sgmiller/tj-cluster/pcb/parts/tinypico-kicad-footprint/5.PNG

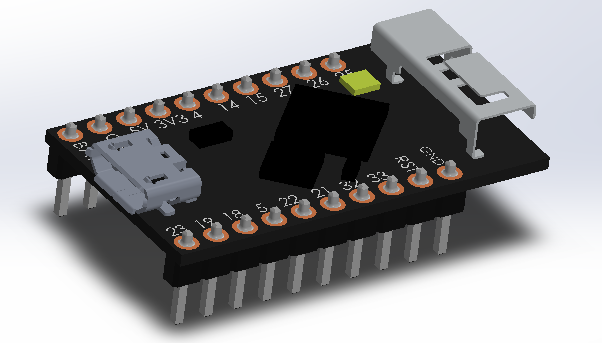
pcb/parts/tinypico-kicad-footprint/5.PNG
