sgmiller/tj-cluster/pcb/parts/tinypico-kicad-footprint/1.PNG

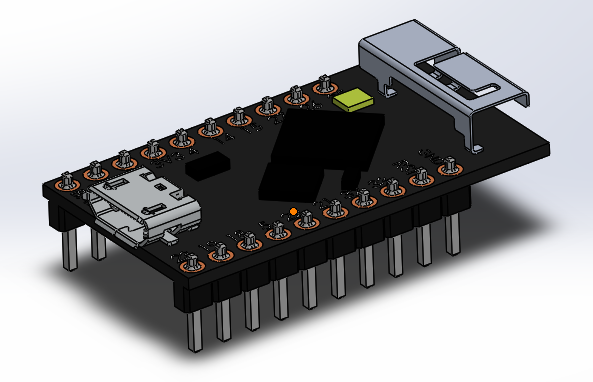
pcb/parts/tinypico-kicad-footprint/1.PNG
