sgmiller/tj-cluster/README.md

# tj-cluster
A custom PCB and software to drive Jeep TJ/XJ Dash clusters' CCD bus and receive CAN messages.
