sgmiller/tj-cluster/pcb/n9works.png

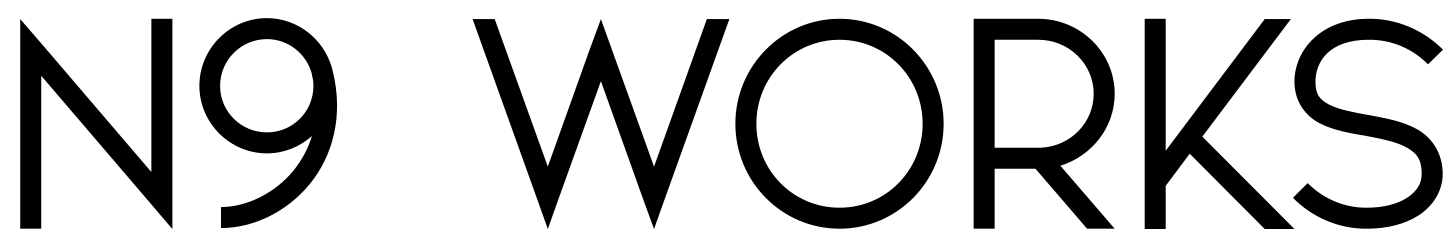
pcb/n9works.png
