sgmiller/tj-cluster/pcb/parts/tinypico-kicad-footprint/README.md

# TinyPICO KiCAD Symbol and Footprint

Based on design files published on 2019-05-21

[https://www.tinypico.com/](https://www.tinypico.com/)

[TinyPICO on crowdsupply](https://www.crowdsupply.com/unexpected-maker/tinypico)
