sgmiller/tj-cluster/pcb/XTJ-IC-Arbiter.ods

Source: | /home/scott/src/tj-cluster/pcb/XTJ-IC-Arbiter.kicad_sch
Date: | Mon 29 Aug 2022 05:52:24 PM CDT
Tool: | Eeschema 6.0.7-f9a2dced07~116~ubuntu20.04.1
Generator: | /usr/share/kicad/plugins/bom_csv_grouped_by_value_with_fp.py
Component Count: | 47
Ref | Qnty | PPU | Cost | Value | Cmp name | Footprint | Description | Vendor
C1, C4, | 2 | $0.28 | $0.56 | 3.3nF | C_Small | Capacitor_THT:C_Disc_D3.8mm_W2.6mm_P2.50mm | Unpolarized capacitor, small symbol
C2, C3, C5, | 3 | $0.24 | $0.73 | 25pF | C_Small | Capacitor_THT:C_Disc_D6.5mm_W4mm_P6.4mm | Unpolarized capacitor, small symbol
C6, C7, C8, C12, C13, C14, | 6 | $0.28 | $1.68 | 0.1uF | C | Capacitor_THT:C_Disc_D3.8mm_W2.6mm_P2.50mm
 | 0 | $0.28 | $0.00 | 0.1uf | C | Capacitor_THT:C_Disc_D3.8mm_W2.6mm_P2.50mm
C9, | 1 | $0.28 | $0.28 | 10nF | C_Small | Capacitor_THT:C_Axial_L3.8mm_D2.6mm_P7.50mm_Horizontal | Unpolarized capacitor, small symbol
C10, | 1 | $0.28 | $0.28 | 100uF | CP | Capacitor_THT:CP_Radial_D8.0mm_P3.50mm
C11, | 1 | $0.33 | $0.33 | 68uF | CP | Capacitor_THT:C_Radial_D6.3mm_H7.0mm_P2.50mm
D1, D2, | 2 | $0.25 | $0.50 | 1N4728 | D_Zener | Diode_THT:D_DO-41_SOD81_P7.62mm_Horizontal
D3, | 1 | $0.43 | $0.43 | P6KE39CA | P6KE39CA | Diode_THT:D_DO-15_P10.16mm_Horizontal | DO-15 Bidirectional TVS Diode, 39V, 600W, Alternate KiCAD Library
D4, D6, D7, D8, D10, | 5 | $0.14 | $0.70 | 3.3v | D_Zener | Diode_THT:D_DO-35_SOD27_P7.62mm_Horizontal | Zener diode
D5, D9, D12, D15, D16, | 5 | $0.32 | $1.60 | P6KE6.8CA | P6KE6.8CA | Diode_THT:D_DO-15_P10.16mm_Horizontal | DO-15 Bidirectional TVS Diode, 6.8V, 600W, Alternate KiCAD Library
D13, | 1 | $0.25 | $0.25 | 550mV | D_Zener | Diode_THT:D_DO-41_SOD81_P7.62mm_Horizontal
D14, | 1 | $0.39 | $0.39 | P6KE6.8A | P6KE6.8A | Diode_THT:D_DO-15_P10.16mm_Horizontal | DO-15 Unidirectional TVS diode, 6.8V, 600W, Alternate KiCAD Library
H1, H2, | 2 |  | $0.00 | MountingHole_Pad | MountingHole_Pad | MountingHole:MountingHole_3.2mm_M3 | Mounting Hole with connection
J3, | 1 | $25.13 | $25.13 | DTM13-12PA-R008 | DTM13-12PA-R008 | DTM13:TE_DTM13-12PA-R008
L1, | 1 | $0.50 | $0.50 | 47uH | L | Inductor_THT:L_Radial_D8.7mm_P5.00mm_Fastron_07HCP
OC1, | 1 | $1.79 | $1.79 | Optocoupler_Generic | Optocoupler_Generic | Package_DIP:DIP-4_W7.62mm | Optocoupler, Transistor output, Generic symbol, Alternate KiCAD Library
R1, R2, | 2 | $0.07 | $0.14 | 10ohm | R_Small | Resistor_THT:R_Axial_DIN0207_L6.3mm_D2.5mm_P7.62mm_Horizontal | Resistor, small symbol
R3, R11, | 2 | $0.10 | $0.20 | 120ohm | R_Small | Resistor_THT:R_Axial_DIN0207_L6.3mm_D2.5mm_P7.62mm_Horizontal | Resistor, small symbol
R7, | 1 | $0.08 | $0.08 | 2.2Kohm | R | Resistor_THT:R_Axial_DIN0207_L6.3mm_D2.5mm_P7.62mm_Horizontal | Resistor
R8, | 1 | $0.10 | $0.10 | 13Kohm | R | Resistor_THT:R_Axial_DIN0207_L6.3mm_D2.5mm_P7.62mm_Horizontal | Resistor
R9, | 1 | $0.63 | $0.63 | 20kOhm | R_Small | Resistor_THT:R_Axial_DIN0207_L6.3mm_D2.5mm_P7.62mm_Horizontal | Resistor, small symbol
R10, | 1 | $0.10 | $0.10 | 10kOhm | R_Small | Resistor_THT:R_Axial_DIN0207_L6.3mm_D2.5mm_P7.62mm_Horizontal | Resistor, small symbol
SW2, | 1 | $1.02 | $1.02 | SW_DIP_x02 | SW_DIP_x02 | Button_Switch_THT:SW_DIP_SPSTx02_Slide_9.78x7.26mm_W7.62mm_P2.54mm | 2x DIP Switch, Single Pole Single Throw (SPST) switch, small symbol
U1, | 1 | $5.60 | $5.60 | LM2672N-5.0 | LM2672N-5.0 | Package_DIP:DIP-8_W7.62mm | 5V, 1A Step-Down Voltage Regulator, DIP-8
U2, | 1 | $5.80 | $5.80 | CDP68HC68S1 | CDP68HC68S1 | Transceivers:CDP68HC68S1
U3, | 1 | $24.38 | $24.38 | Teensy4.0 | Teensy4.0 | MCUs:Teensy40_NoSMT
U4, | 1 | $1.51 | $1.51 | MCP2562-H-P | MCP2562-H-P | Package_DIP:DIP-8_W7.62mm | High-Speed CAN Transceiver, 1Mbps, 5V supply, Vio pin, -40C to +150C, DIP-8
N/A | 1 | $0.42 | $0.42 | Wedgelock
N/A | 1 | $17.67 | $17.67 | Automotive Enclosure
N/A | 1 | $3.80 | $3.80 | Deutch Plug
 |  | Total | $96.60
