sgmiller/tj-cluster/pcb/parts/tinypico-kicad-footprint/2.PNG

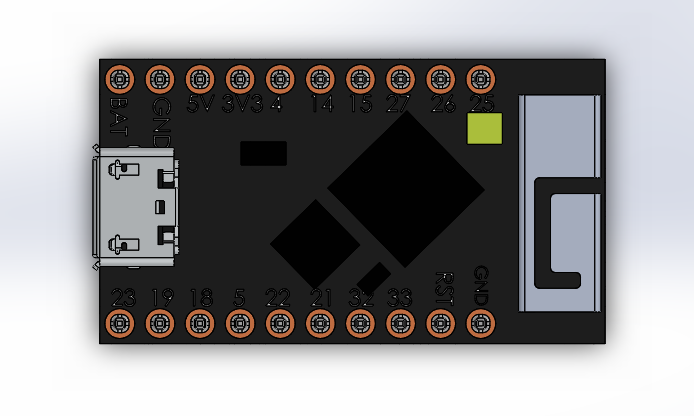
pcb/parts/tinypico-kicad-footprint/2.PNG
