sgmiller/tj-cluster/pcb/parts/tinypico-kicad-footprint/3.PNG

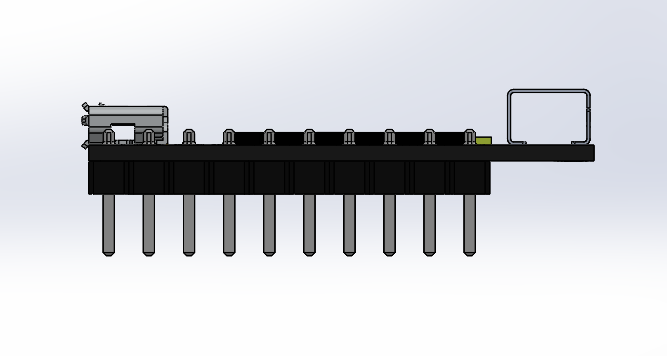
pcb/parts/tinypico-kicad-footprint/3.PNG
