sgmiller/tj-cluster/pcb/parts/tinypico-kicad-footprint/4.PNG

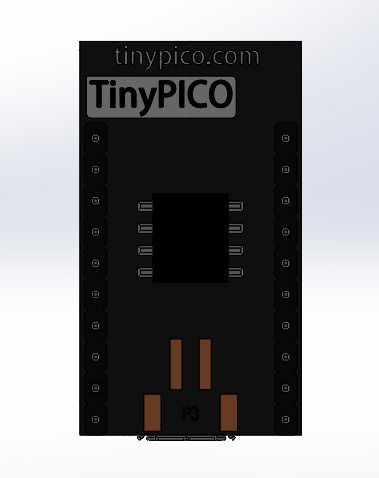
pcb/parts/tinypico-kicad-footprint/4.PNG
