sgmiller/tj-cluster/pcb/parts/DTM13/DTM13-12PA-R008.step

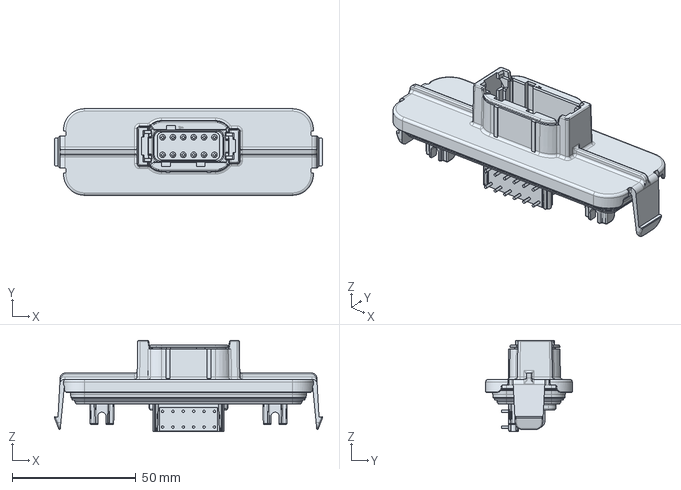
[picture p8: CAD file, 2022-06-14]
pcb/parts/DTM13/DTM13-12PA-R008.step
108.3 x 35.0 x 36.9 mm
