sgmiller/tj-cluster/pcb/parts/enclosure/EEC-325X4A.step

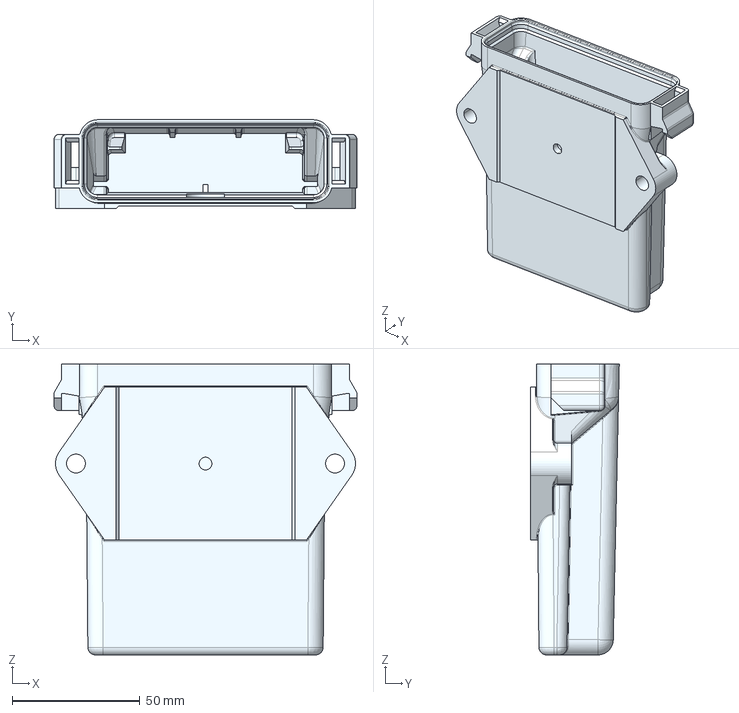
[picture p9: CAD file, 2025-09-23]
pcb/parts/enclosure/EEC-325X4A.step
118.8 x 34.7 x 114.0 mm
