sgmiller/tj-cluster/pcb/parts/FA18X7R1H472KNU00/3D/FA18X7R1H472KNU00.stp

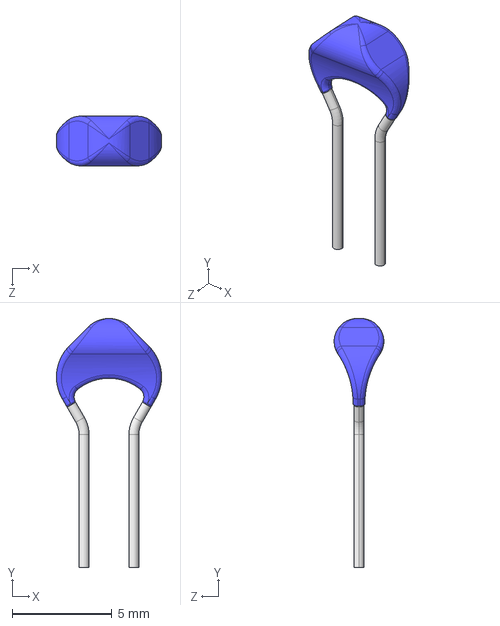
[picture p10: CAD file, 2025-09-12]
pcb/parts/FA18X7R1H472KNU00/3D/FA18X7R1H472KNU00.stp
5.28 x 12.5 x 2.50 mm
