sgmiller/tj-cluster/pcb/parts/FA24X7R1H105KRU06/3D/FA24X7R1H105KRU06.stp

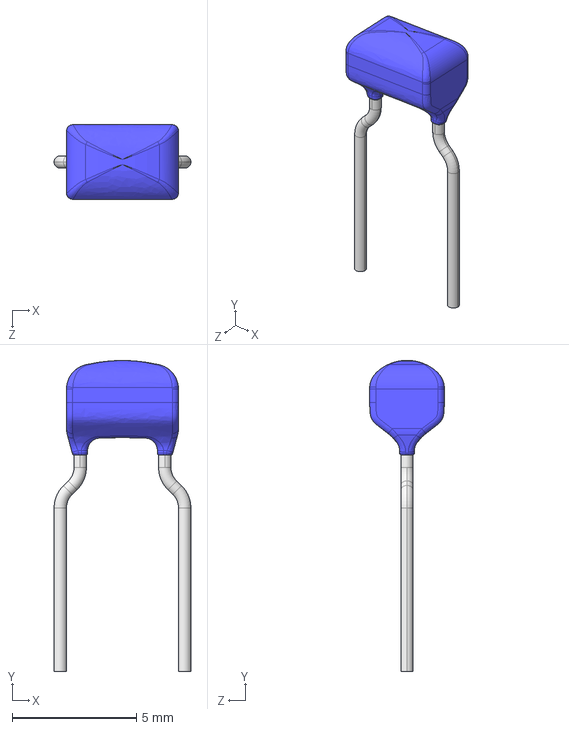
[picture p11: CAD file, 2025-09-07]
pcb/parts/FA24X7R1H105KRU06/3D/FA24X7R1H105KRU06.stp
5.50 x 12.5 x 3.00 mm
