sgmiller/tj-cluster/pcb/parts/fuse/MF-MSMF050.step

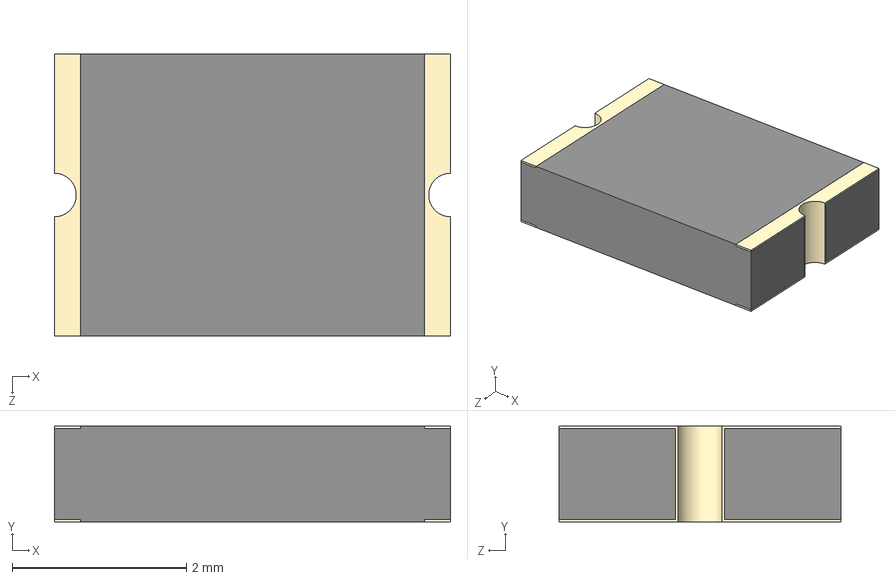
[picture p12: CAD file, 2025-11-19]
pcb/parts/fuse/MF-MSMF050.step
4.55 x 1.10 x 3.24 mm
