sgmiller/tj-cluster/pcb/parts/Jumpers/TSW-101-07-T-D.step

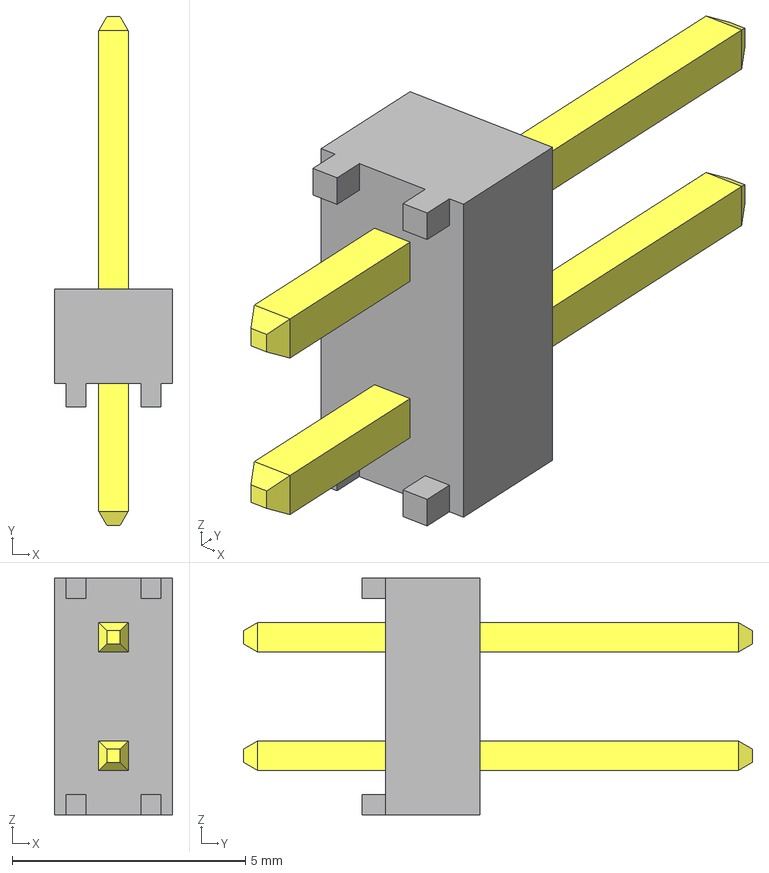
[picture p13: CAD file, 2022-06-14]
pcb/parts/Jumpers/TSW-101-07-T-D.step
2.54 x 10.9 x 5.08 mm
_TSW-101-07-T-D_body
_T-1S6-07-TSW-1-07-1-D
