sgmiller/tj-cluster/pcb/parts/MCUs/Teensy_4_Pins.FCStd

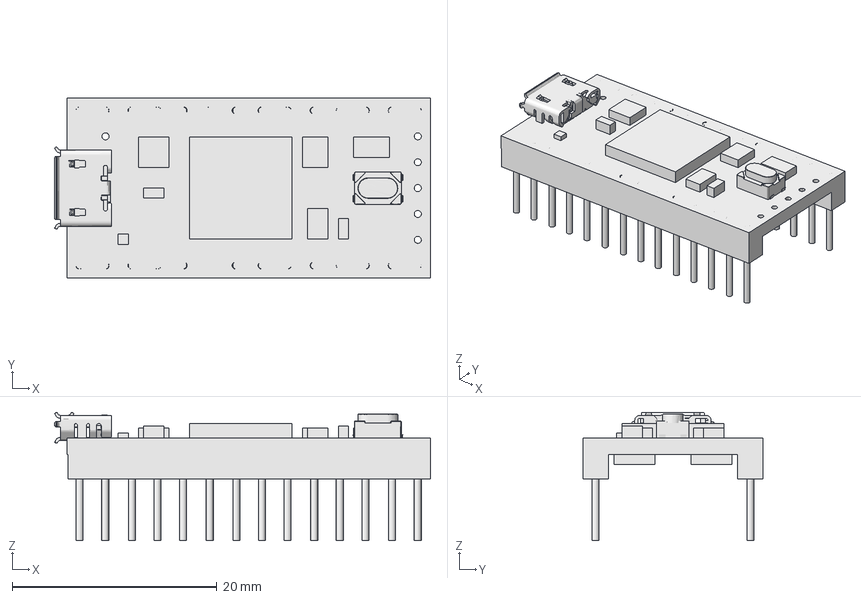
[picture p14: CAD file, 2022-07-18]
pcb/parts/MCUs/Teensy_4_Pins.FCStd
36.7 x 17.6 x 12.5 mm
