sgmiller/tj-cluster/pcb/parts/Power_Regulator/LM2591HVT-5.0.step

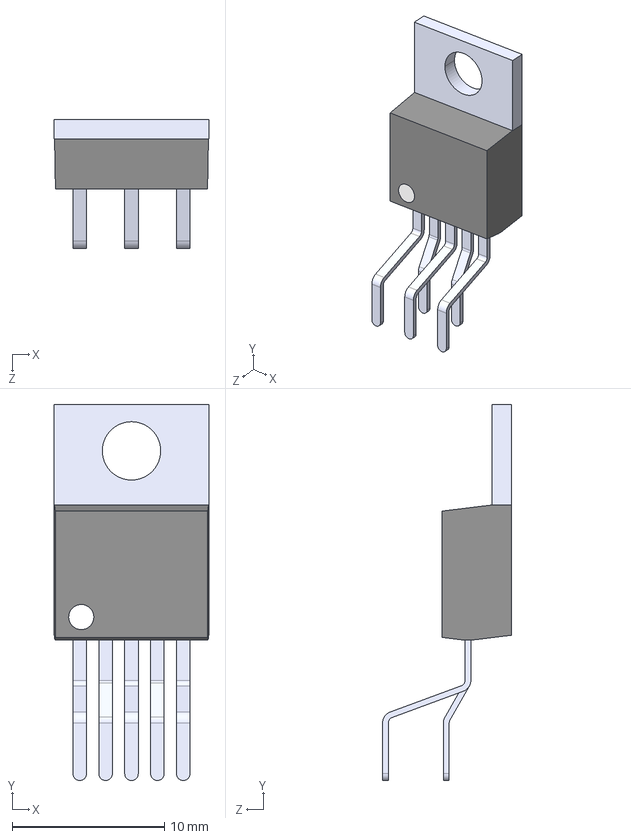
[picture p15: CAD file, 2022-07-01]
pcb/parts/Power_Regulator/LM2591HVT-5.0.step
10.2 x 24.7 x 8.47 mm
