sgmiller/tj-cluster/pcb/parts/RLB0914-470KL/3D/RLB0914-470KL.stp

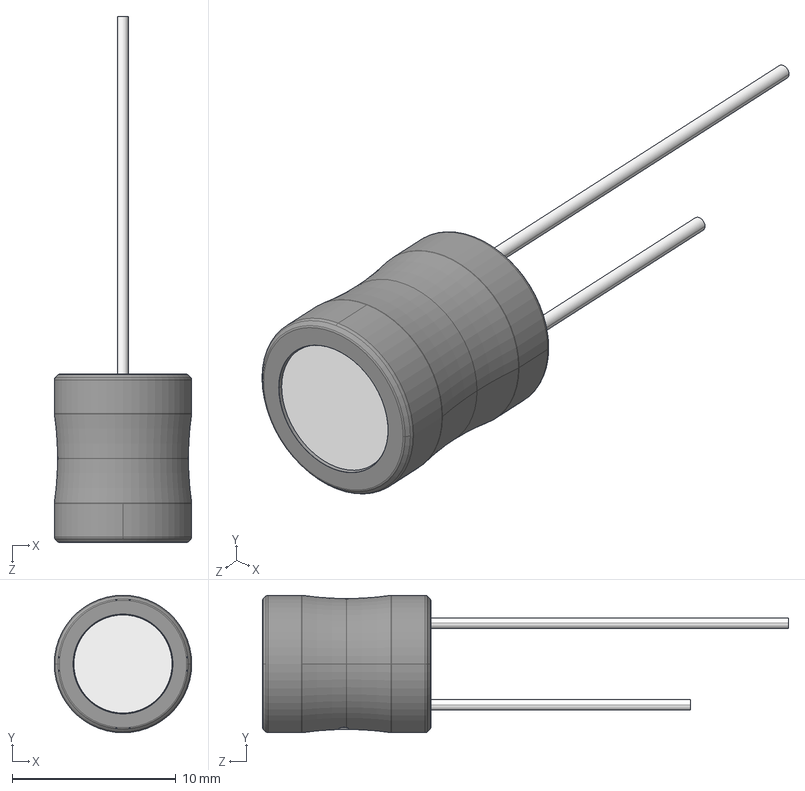
[picture p16: CAD file, 2025-09-07]
pcb/parts/RLB0914-470KL/3D/RLB0914-470KL.stp
8.40 x 8.40 x 32.1 mm
