sgmiller/tj-cluster/pcb/parts/RXEF050S/3D/RXEF050S.stp

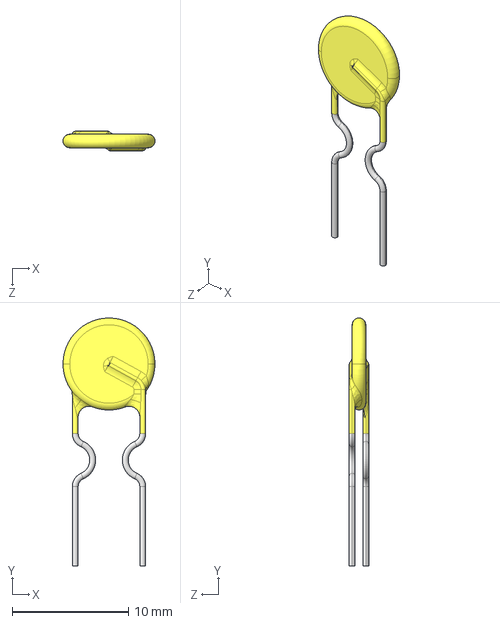
[picture p17: CAD file, 2025-11-18]
pcb/parts/RXEF050S/3D/RXEF050S.stp
7.90 x 21.3 x 1.68 mm
