sgmiller/tj-cluster/pcb/parts/SA26A/3D/SA26A.stp

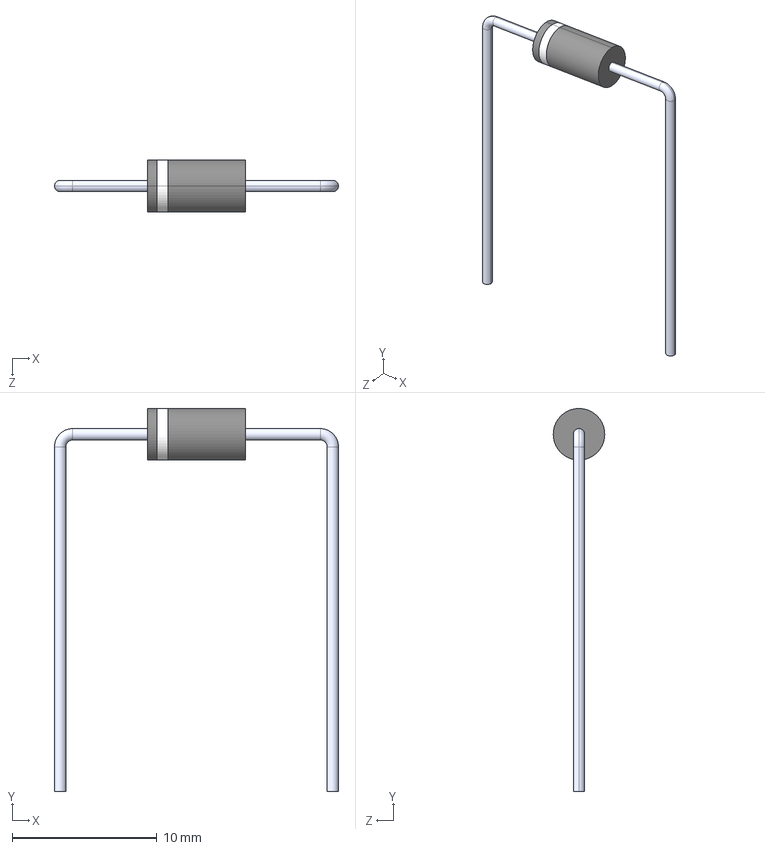
[picture p18: CAD file, 2025-10-22]
pcb/parts/SA26A/3D/SA26A.stp
19.6 x 26.4 x 3.56 mm
P6KE10_3_1
P6KE10_1_1
P6KE10_4 x 2
