sgmiller/tj-cluster/pcb/parts/TLV3704IN/3D/TLV3704IN.stp

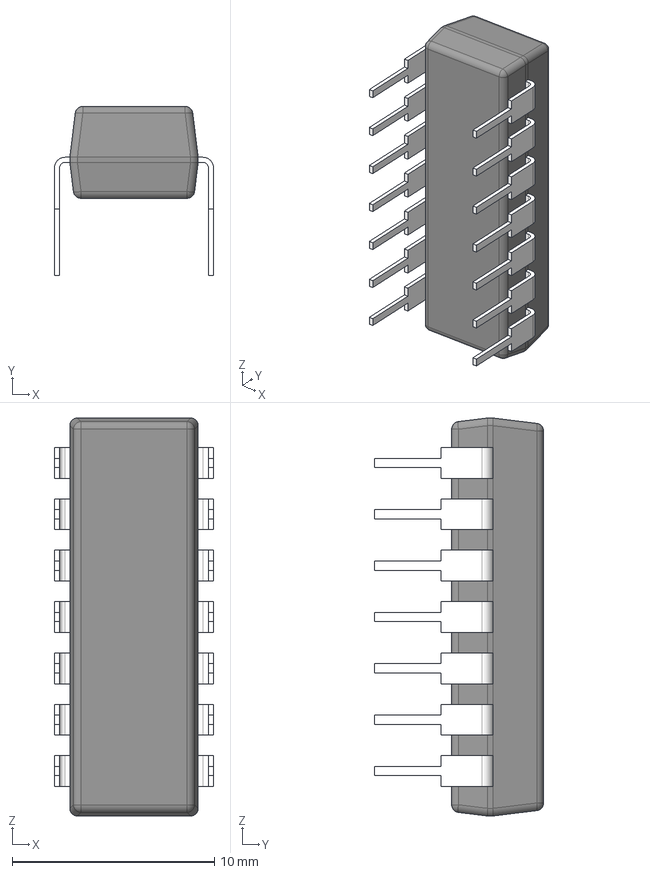
[picture p19: CAD file, 2025-09-07]
pcb/parts/TLV3704IN/3D/TLV3704IN.stp
7.87 x 8.37 x 19.7 mm
BODY_N0014A_AF0
LEAD_N0014A_AF1
LEAD_N0014A x 10
LEAD_N0014A_AF3
LEAD_N0014A_AF0
LEAD_N0014A_AF2
