sgmiller/tj-cluster/pcb/parts/G6L-1P_DC5.step

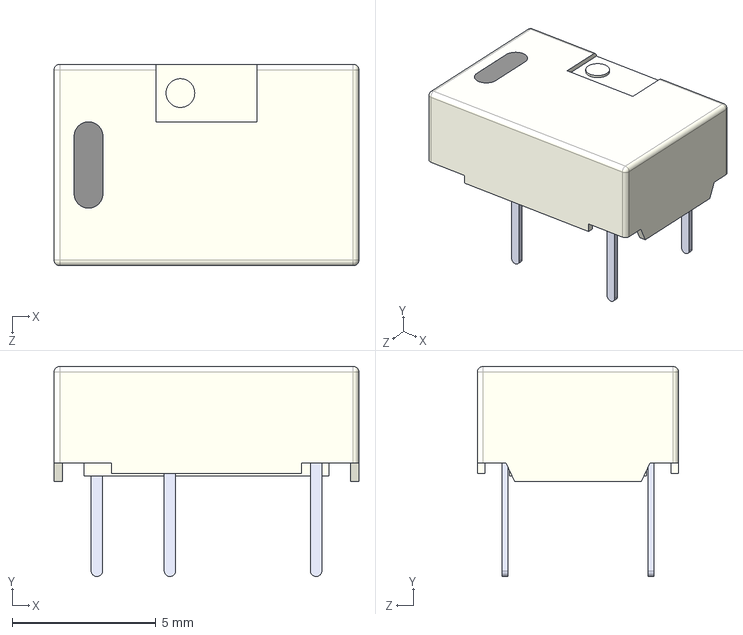
[picture p20: CAD file, 2025-08-30]
pcb/parts/G6L-1P_DC5.step
10.6 x 7.30 x 7.00 mm
