sgmiller/tj-cluster/pcb/parts/39811000000.step

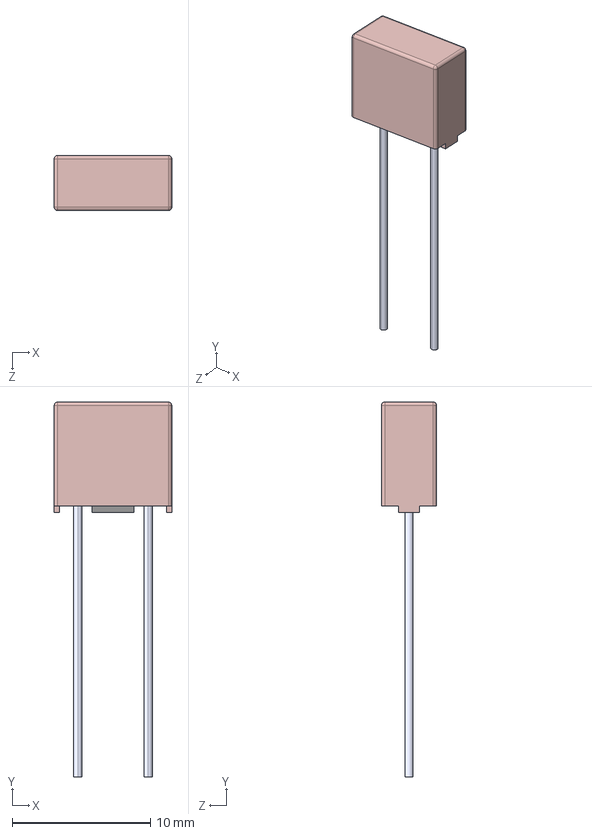
[picture p21: CAD file, 2025-10-07]
pcb/parts/39811000000.step
8.50 x 27.1 x 4.00 mm
