sgmiller/tj-cluster/(list of files, drawings)

Other design files:
pcb/XTJ-IC-Arbiter.dsn
