sgmiller/tj-cluster/pcb/XTJ-IC-Arbiter.kicad_pcb

## KiCad design pcb/XTJ-IC-Arbiter.kicad_pcb (2026-08-17)

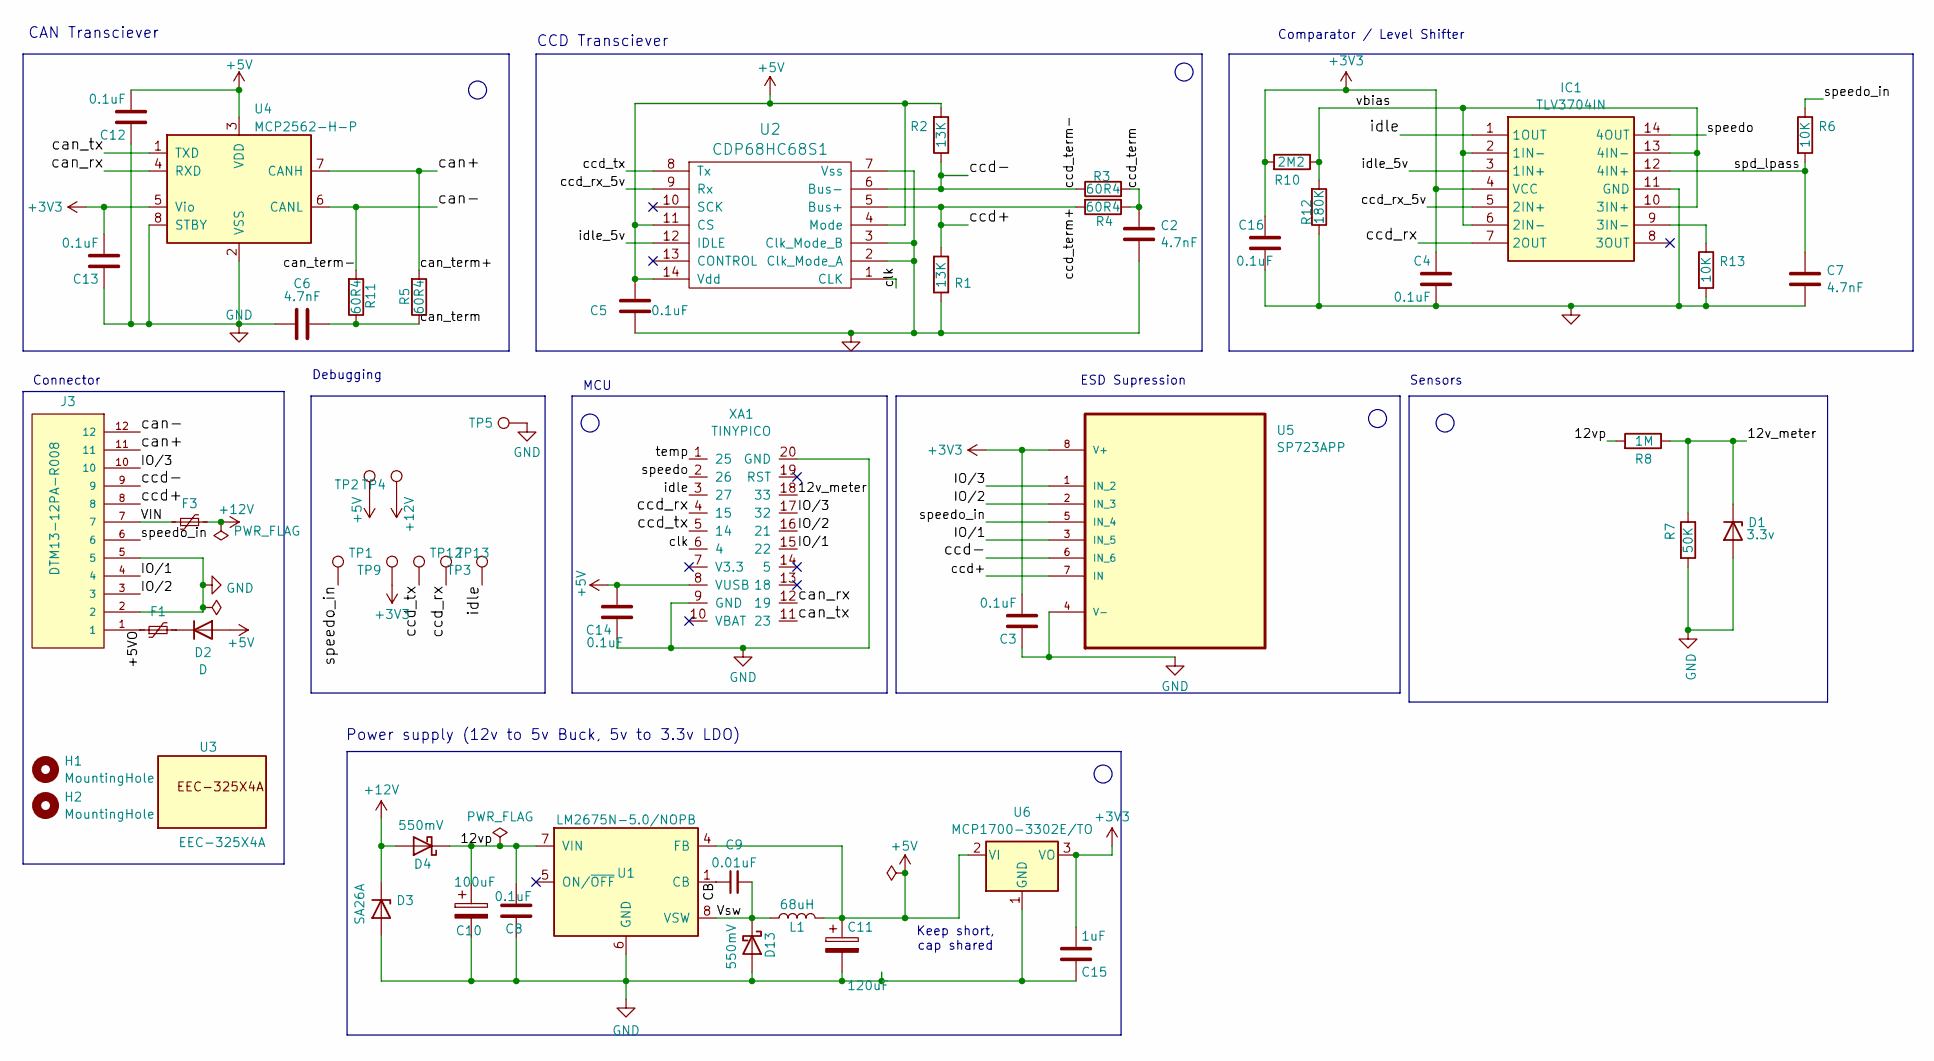
[picture p22: schematic XTJ-IC-Arbiter.kicad_sch, XJ/TJ CCD/CAN bus arbiter]

Parts:
C2, C6, C7: 4.7nF; C_Disc_D3.8mm_W2.6mm_P2.50mm; MPN AR151C472K4R
C3, C4, C5, C8, C12, C13, C14, C16: 0.1uF; C_Disc_D4.7mm_W2.5mm_P5.00mm; MPN K103K10X7RF53L2
C9: 0.01uF; C_Disc_D3.8mm_W2.6mm_P2.50mm; MPN K103K10X7RF53L2
C10: 100uF; C_Radial_D8.0mm_H11.5mm_P3.50mm; MPN EEU-FR1V101
C11: 120uF; CP_Radial_D8.0mm_P3.50mm; MPN EEU-FR1H121L
C15: 1uF; FA24; MPN FA24X7R1H105KRU06
D1: 3.3v; D_DO-35_SOD27_P7.62mm_Horizontal; MPN TZX3V3B-TR
D2: D; D_DO-41_SOD81_P7.62mm_Horizontal; MPN 1N40001GH
D3: SA26A; D_DO-15_P10.16mm_Horizontal; MPN SA26A; Mouser Part Number 576-SA26CA
D4, D13: 550mV; D_DO-41_SOD81_P7.62mm_Horizontal; MPN MBR160RLG
F1, F3: Polyfuse_Small; Fuse_1812_4532Metric_Pad1.30x3.40mm_HandSolder; MPN MF-MSMF050/30X-2
H1, H2: MountingHole; MountingHole_3mm
IC1: TLV3704IN; DIP794W53P254L1930H508Q14N; Mouser Part Number 595-TLV3704IN
J3: DTM13-12PA-R008; TE_DTM13-12PA-R008
L1: 68uH; L_Radial_D7.8mm_P5.00mm_Fastron_07HCP; MPN 744731680
R1, R2: 13K; R_Axial_DIN0207_L6.3mm_D2.5mm_P7.62mm_Horizontal; MPN MF1/4DC1302F
R3, R4, R5, R11: 60R4; R_Axial_DIN0207_L6.3mm_D2.5mm_P7.62mm_Horizontal; MPN CMF5560R400FHEK
R6, R13: 10K; R_Axial_DIN0207_L6.3mm_D2.5mm_P7.62mm_Horizontal; MPN MF1/4DC4701F
R7: 50K; R_Axial_DIN0207_L6.3mm_D2.5mm_P7.62mm_Horizontal; MPN MF1/4DC4701F
R8: 1M; R_Axial_DIN0207_L6.3mm_D2.5mm_P7.62mm_Horizontal; MPN MFR-25FBF52-100K
R10: 2M2; R_Axial_DIN0207_L6.3mm_D2.5mm_P7.62mm_Horizontal; MPN MF1/4LCT52R225J
R12: 180K; R_Axial_DIN0207_L6.3mm_D2.5mm_P7.62mm_Horizontal; MPN MF1/4DCT52R1803F
TP1, TP3, TP5, TP12, TP13: TestPoint; TestPoint_Loop_D2.50mm_Drill1.0mm; MPN 534-5267
TP2, TP4, TP9: TestPoint; TestPoint_Plated_Hole_D2.0mm; MPN 534-5267
U1: LM2675N-5.0/NOPB; DIP-8_W7.62mm; MPN LM2675N-5.0/NOPB
U2: CDP68HC68S1; DIP-14_W7.62mm; MPN CDP68HC68S1
U3: EEC-325X4A; TE_EEC-325X4A; PARTREV F
U4: MCP2562-H-P; DIP-8_W7.62mm; MPN MCP2562-H-P
U5: SP723APP; DIP-8_W7.62mm; MPN SP723APP
U6: MCP1700-3302E/TO; TO-92_Inline_Wide; MPN MCP1700-3302E/TO
XA1: TINYPICO

Connections:
+3V3: C3.2, C4.1, C13.2, C15.2, C16.2, IC1.4 (VCC), R10.2, TP9.1, U4.5 (Vio), U5.8 (V+), U6.3 (VO)
+5V: C5.2, C11.1, C12.2, C14.2, D2.2 (A), L1.2, R2.2, TP2.1, U1.4 (FB), U2.4 (Mode), U2.11 (CS), U2.14 (Vdd), U4.3 (VDD), U6.2 (VI), XA1.8 (VUSB)
+12V: D3.1 (K), D4.2 (A), F3.2, TP4.1
/12v_meter: D1.1 (K), R7.1, R8.1, XA1.18 (33)
/12vp: C8.2, C10.1, D4.1 (K), R8.2, U1.7 (VIN)
/+5VO: F1.1, J3.1
/CB: C9.1, U1.1 (CB)
/IO/1: J3.4, U5.3 (IN_5), XA1.15 (22)
/IO/2: J3.3, U5.2 (IN_3), XA1.16 (21)
/IO/3: J3.10, U5.1 (IN_2), XA1.17 (32)
/VIN: F3.1, J3.7
/Vsw: C9.2, D13.1 (K), L1.1, U1.8 (VSW)
/can+: J3.11, R5.2, U4.7 (CANH)
/can-: J3.12, R11.2, U4.6 (CANL)
/can_rx: U4.4 (RXD), XA1.12 (19)
/can_term: C6.2, R5.1, R11.1
/can_tx: U4.1 (TXD), XA1.11 (23)
/ccd+: J3.8, R1.2, R4.2, U2.5 (Bus+), U5.7 (IN)
/ccd-: J3.9, R2.1, R3.1, U2.6 (Bus-), U5.6 (IN_6)
/ccd_rx: IC1.7 (2OUT), TP13.1, XA1.4 (15)
/ccd_rx_5v: IC1.5 (2IN+), U2.9 (Rx)
/ccd_term: C2.2, R3.2, R4.1
/ccd_tx: TP12.1, U2.8 (Tx), XA1.5 (14)
/clk: U2.1 (CLK), XA1.6 (4)
/idle: IC1.1 (1OUT), TP3.1, XA1.3 (27)
/idle_5v: IC1.3 (1IN+), U2.12 (IDLE)
/spd_lpass: C7.2, IC1.12 (4IN+), R6.2
/speedo: IC1.14 (4OUT), XA1.2 (26)
/speedo_in: J3.6, R6.1, TP1.1, U5.5 (IN_4)
/temp: XA1.1 (25)
/vbias: IC1.2 (1IN-), IC1.6 (2IN-), IC1.10 (3IN+), IC1.13 (4IN-), R10.1, R12.2
GND: C2.1, C3.1, C4.2, C5.1, C6.1, C7.1, C8.1, C10.2, C11.2, C12.1, C13.1, C14.1, C15.1, C16.1, D1.2 (A), D3.2 (A), D13.2 (A), IC1.11 (GND), J3.2, J3.5, R1.1, R7.2, R12.1, R13.2, TP5.1, U1.6 (GND), U2.2 (Clk_Mode_A), U2.3 (Clk_Mode_B), U2.7 (Vss), U4.2 (VSS), U4.8 (STBY), U5.4 (V-), U6.1 (GND), XA1.9 (GND), XA1.20 (GND)
unnamed: D2.1 (K), F1.2
unnamed: IC1.9 (3IN-), R13.1

Notes on the sheet:
CAN Transciever
MCU
Debugging
Sensors
CCD Transciever
ESD Supression
Power supply (12v to 5v Buck, 5v to 3.3v LDO)
Keep short, cap shared
Comparator / Level Shifter
Connector

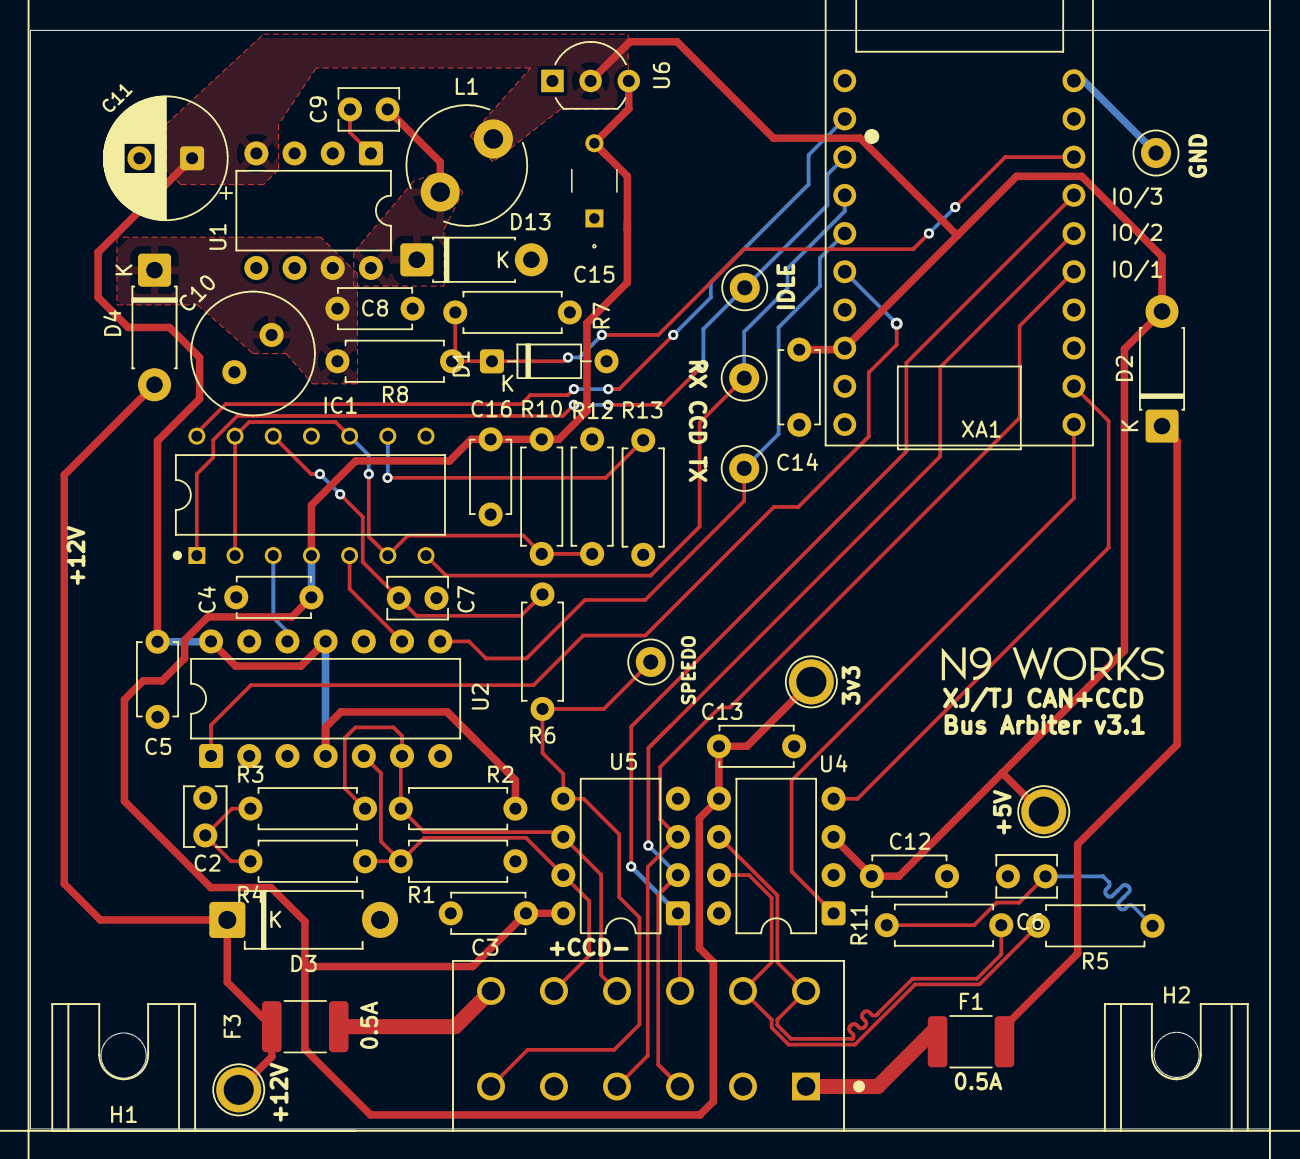
[picture p23: board XTJ-IC-Arbiter.kicad_pcb from above]

Board: 2 copper layers, 82.4 x 73.0 mm, 54 parts (0 on the bottom side), 33 nets.
