sgmiller/tj-cluster/include/main.h

#ifndef MAIN_H
#define MAIN_H

#include <Arduino.h>

const int ADC_LUT[4096] = { 0,
208,208,208,208,208,208,208,208,208,208,208,208,208,208,208,208,
208,208,208,208,208,208,208,208,208,208,208,208,208,208,208,208,
208,208,208,208,208,208,208,208,208,208,208,208,208,208,208,208,
208,208,208,208,208,208,208,208,208,208,208,208,208,208,208,208,
208,208,208,208,208,208,208,208,208,208,208,208,208,208,208,208,
208,208,208,208,208,208,208,208,208,208,208,208,208,208,208,208,
208,208,208,208,208,208,208,208,208,208,208,208,208,208,208,208,
208,208,208,208,208,208,208,208,208,208,208,208,208,208,208,208,
208,208,208,208,208,208,208,208,208,208,209,210,210,211,211,212,
207,213,214,214,215,215,216,217,217,218,218,219,220,220,221,221,
222,240,233,226,243,244,245,246,247,249,250,251,252,253,254,204,
256,257,204,258,259,259,260,261,261,262,263,203,203,265,203,266,
267,267,268,269,269,270,271,202,202,202,276,278,280,282,283,285,
287,289,290,291,293,294,296,297,298,300,301,303,304,306,307,309,
310,312,313,315,316,318,320,321,323,324,326,327,329,330,332,334,
335,198,198,339,340,341,342,343,344,345,346,347,348,197,197,351,
353,354,355,356,357,358,359,196,362,363,364,365,366,367,368,368,
369,369,370,370,195,371,371,372,372,372,373,373,194,374,194,375,
375,376,376,376,377,377,193,378,193,379,379,193,380,380,381,381,
382,382,192,401,383,406,408,411,413,415,416,417,418,419,419,420,
421,191,422,423,424,424,425,426,427,190,428,429,430,430,431,432,
432,433,433,434,434,435,189,436,189,437,438,438,439,439,440,440,
188,188,188,442,443,443,444,444,445,445,446,446,460,453,467,469,
470,472,473,474,476,477,479,480,186,186,482,483,484,485,485,486,
487,488,489,489,490,491,492,493,493,494,495,496,496,497,498,184,
184,500,501,501,502,503,504,504,505,4094,507,507,508,509,509,510,
511,512,513,514,515,182,182,519,520,521,523,524,525,527,528,529,
531,532,534,536,537,539,540,542,543,545,547,548,550,180,554,555,
557,559,560,561,562,562,563,564,565,565,566,567,568,568,569,570,
571,572,572,573,574,178,575,577,579,581,583,585,587,590,592,593,
593,594,177,595,596,597,4094,598,599,600,600,601,176,176,603,604,
605,605,606,607,607,608,609,175,175,611,612,612,613,614,615,615,
616,617,617,618,619,620,620,621,622,622,623,624,626,628,629,631,
633,635,637,173,640,641,641,642,643,643,644,644,645,646,646,647,
648,648,649,172,650,651,651,652,653,653,654,171,655,656,171,659,
660,661,662,664,665,666,668,669,670,671,170,673,674,675,170,677,
678,679,680,681,682,683,169,685,685,686,687,690,695,701,704,705,
705,706,706,707,707,168,708,709,709,168,710,711,711,712,712,713,
713,167,714,715,715,716,716,717,717,718,718,719,719,725,736,737,
738,739,740,741,166,743,744,745,746,747,748,749,165,752,753,754,
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
} ;

void clusterWrite();
void handleHeartbeat();
void handleSpeedSensor();
void watchdogFeed();
void setupSpeedo();

#endif
