sgmiller/tj-cluster/(commit log)

2022-06-05 Add PCB
    [Circuit-rewrite.kicad_pcb, Circuit.dsn, Circuit.kicad_pcb, Circuit.kicad_sch, canbus.kicad_sch, power.kicad_sch]
2022-06-08 Working oil and battery gauges
    [Circuit.csv, Circuit.kicad_pcb]
2022-06-08 Not these
    [Circuit.csv]
2022-06-09 Implement Teensy watchdog, and light the SKIM lamp if we reset due to it
    [instruments.cpp, main.cpp]
2022-06-09 Code for speedometer handling and odometer increment (not quite)
    [Circuit-B_Cu.gbr, Circuit-B_Mask.gbr, Circuit-B_Silkscreen.gbr, Circuit-Edge_Cuts.gbr, Circuit-F_Cu.gbr, Circuit-F_Mask.gbr, Circuit-F_Silkscreen.gbr, Circuit-NPTH.drl]
2022-06-10 Blink onboard LED on activity
2022-06-11 commit before changing can transceiver
    [Circuit.kicad_pcb, Circuit.kicad_sch]
2022-06-14 Move IO pins to more useful Teensy pins
    [Circuit.csv, Circuit.kicad_pcb, Circuit.kicad_sch]
2022-06-14 Add footprints
    [DTM13-12PA-R008.step, TSW-101-07-T-D.step, TSW-101-07-T-D.stp]
2022-06-14 remove gerbers
    [Circuit-B_Cu.gbr, Circuit-B_Mask.gbr, Circuit-B_Silkscreen.gbr, Circuit-Edge_Cuts.gbr, Circuit-F_Cu.gbr, Circuit-F_Mask.gbr, Circuit-F_Silkscreen.gbr]
2022-06-14 more footprints
    [Teensy_4.0_Assembly.STEP]
2022-06-14 Update teensy footprint
    [Circuit.kicad_pcb]
2022-06-15 get rid of ancient rewrite
    [Circuit-rewrite.kicad_pcb]
2022-06-16 Move speedo to a FlexPWM pin
    [Circuit.kicad_pcb, Circuit.kicad_sch]
2022-06-24 Update for actual parts ordered from Mouser
    [Circuit.kicad_pcb, Circuit.kicad_sch]
2022-06-28 CDP 3d model
    [Circuit.kicad_pcb, Circuit.kicad_sch]
2022-06-28 Tidy up capacitors
    [Circuit.kicad_pcb]
2022-06-28 move via cleanup
    [Circuit.kicad_pcb]
2022-06-29 Add overvoltage protection to the 12v measure pin
    [Circuit.kicad_pcb, Circuit.kicad_sch]
2022-06-30 Add 3.3v overvolt protection zeners
    [Circuit.kicad_pcb, Circuit.kicad_sch]
2022-06-30 Use correctly sized TVS diodes for the CCD bus
    [Circuit.kicad_pcb, Circuit.kicad_sch]
2022-06-30 Move CCD lines farther from power
    [Circuit.kicad_pcb]
2022-06-30 More tweaks
    [Circuit.kicad_pcb]
2022-06-30 Silkscreen tweaks
    [Circuit.kicad_pcb]
2022-07-01 Undo attempt to simplify jumpers
    [Circuit.kicad_pcb, Circuit.kicad_sch, LM2591HVT-5.0.step]
2022-07-01 Project rename
    [Circuit.csv, XTJ-IC-Arbiter.dsn, XTJ-IC-Arbiter.kicad_pcb, XTJ-IC-Arbiter.kicad_sch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]
2022-07-01 Complete rename
    [XTJ-IC-Arbiter.kicad_pcb]
2022-07-01 Refactor away the need for interval timers, which we have in limited quantity
2022-07-05 Add voltage divider for idle
    [XTJ-IC-Arbiter.kicad_pcb, XTJ-IC-Arbiter.kicad_sch]
2022-07-08 Copy changes from the multi-ccd branch
    [XTJ-IC-Arbiter.kicad_pcb, XTJ-IC-Arbiter.kicad_sch]
2022-07-08 Rationalize CCD filters
    [XTJ-IC-Arbiter.kicad_pcb, XTJ-IC-Arbiter.kicad_sch]
2022-07-09 Re-add TVS diodes to CCD inputs
    [XTJ-IC-Arbiter.kicad_pcb, XTJ-IC-Arbiter.kicad_sch]
2022-07-09 Geographical reannotate
    [XTJ-IC-Arbiter.kicad_pcb, XTJ-IC-Arbiter.kicad_sch]
2022-07-10 Slightly reorganize TVS matrix to clean up traces
    [XTJ-IC-Arbiter.kicad_pcb, XTJ-IC-Arbiter.kicad_sch]
2022-07-17 remove mounting grounds
    [XTJ-IC-Arbiter.kicad_pcb, XTJ-IC-Arbiter.kicad_sch]
2022-07-17 Shorten distance to bypass capacitor
    [XTJ-IC-Arbiter.kicad_pcb, XTJ-IC-Arbiter.kicad_sch]
2022-07-17 After breadboarding, eliminate LDO reference regulator
    [XTJ-IC-Arbiter.kicad_pcb, XTJ-IC-Arbiter.kicad_sch]
2022-07-17 Correct DRC errors
    [XTJ-IC-Arbiter.kicad_pcb]
2022-07-17 Add parallel traces to CAN/CCD routes so there is still a connection if the 120ohm resistor is cut
    [XTJ-IC-Arbiter.kicad_pcb]
2022-07-18 More tweaking
    [Teensy_4_Pins.FCStd, XTJ-IC-Arbiter.kicad_pcb, XTJ-IC-Arbiter.kicad_sch]
2022-07-18 Switch from jumpers to DIP switches for CCD bias, CCD bus termination. Add DIP switch for selectable CAN bus termination. DIP switches should hold up in vibration, where I worry a jumper might rattle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
    [XTJ-IC-Arbiter.kicad_pcb, XTJ-IC-Arbiter.kicad_sch]
2022-07-19 Add a level shifter to handle 5v to 3.3v for the CDP<->Teensy
    [XTJ-IC-Arbiter.kicad_pcb, XTJ-IC-Arbiter.kicad_sch]
2022-07-19 tidy wiring
    [XTJ-IC-Arbiter.kicad_pcb]
2022-07-21 Tidy up even more vias
    [XTJ-IC-Arbiter.csv, XTJ-IC-Arbiter.kicad_pcb, XTJ-IC-Arbiter.kicad_sch]
2022-07-21 Improve a couple grounds
    [XTJ-IC-Arbiter.kicad_pcb]
2022-07-27 Design using the CDP transceiver but in TX only, neglecting idle etc
    [XTJ-IC-Arbiter.kicad_pcb, XTJ-IC-Arbiter.kicad_sch]
2022-07-28 Rearrange for tighter CCD signal traces
    [XTJ-IC-Arbiter.kicad_pcb, XTJ-IC-Arbiter.kicad_sch]
2022-07-28 CCD length tuning
    [XTJ-IC-Arbiter.kicad_pcb]
2022-07-28 Tweak CCD routing just a bit more
    [XTJ-IC-Arbiter.kicad_pcb, XTJ-IC-Arbiter.kicad_sch]
2022-07-29 Measure battery more frequently
2022-07-29 Eureka! Finally satisfied with CCD traces
    [XTJ-IC-Arbiter.kicad_pcb, XTJ-IC-Arbiter.kicad_sch]
2022-07-29 One more bypass cap
    [XTJ-IC-Arbiter.kicad_pcb, XTJ-IC-Arbiter.kicad_sch]
2022-07-30 Last minute tweaks and board shrink
    [XTJ-IC-Arbiter.kicad_pcb]
2022-07-31 Footprint double-checks
    [XTJ-IC-Arbiter.kicad_pcb, XTJ-IC-Arbiter.kicad_sch]
2022-07-31 Correct and arrange power components
    [XTJ-IC-Arbiter.kicad_pcb, XTJ-IC-Arbiter.kicad_sch]
2022-07-31 Don't crowd the ground
    [XTJ-IC-Arbiter.kicad_pcb]
2022-07-31 Fix battery calculation
2022-07-31 CCD length tune
    [XTJ-IC-Arbiter.kicad_pcb]
2022-07-31 Last tweaks before manufacture
    [XTJ-IC-Arbiter.kicad_pcb, XTJ-IC-Arbiter.kicad_sch]
2022-07-31 Correct one of the ESD diodes
    [XTJ-IC-Arbiter.kicad_sch]
2022-08-01 Add 12v batt measurement note
2022-09-10 Fixes for CCD filter network
    [XTJ-IC-Arbiter.csv, XTJ-IC-Arbiter.kicad_pcb, XTJ-IC-Arbiter.kicad_sch, XTJ-IC-Arbiter.ods]
2022-09-10 and schematic
    [XTJ-IC-Arbiter.kicad_sch]
2022-09-10 Re-length tune
    [XTJ-IC-Arbiter.kicad_pcb, XTJ-IC-Arbiter.kicad_sch]
2022-09-11 Add a couple backup traces
    [XTJ-IC-Arbiter.kicad_pcb, XTJ-IC-Arbiter.kicad_sch]
2022-09-12 Correct orientation of CCD chip, which was electrically sound but the 3D model was backwards
    [XTJ-IC-Arbiter.kicad_pcb]
2022-09-17 More mods for 1.1
    [XTJ-IC-Arbiter.kicad_pcb, XTJ-IC-Arbiter.kicad_sch]
2022-10-16 Don't place 5v and 12v pins side by side
    [XTJ-IC-Arbiter.kicad_pcb, XTJ-IC-Arbiter.kicad_sch]
2022-10-16 Add overvoltage protection on the 5v line
    [XTJ-IC-Arbiter.kicad_pcb, XTJ-IC-Arbiter.kicad_sch]
2022-10-16 move k
    [XTJ-IC-Arbiter.kicad_pcb, XTJ-IC-Arbiter.kicad_sch]
2024-05-24 Fixes prior to simplification
    [XTJ-IC-Arbiter.kicad_pcb, XTJ-IC-Arbiter.kicad_sch]
2024-05-25 Get rid of errors
    [XTJ-IC-Arbiter.kicad_pcb, XTJ-IC-Arbiter.kicad_sch]
2024-05-26 tune can termination length
    [XTJ-IC-Arbiter.csv, XTJ-IC-Arbiter.kicad_pcb, XTJ-IC-Arbiter.kicad_sch]
2024-05-26 fix board edge
    [XTJ-IC-Arbiter.kicad_pcb]
2024-05-26 cleanup bypass caps
    [XTJ-IC-Arbiter.kicad_pcb]
2024-05-26 get rid of 5v feed text
    [XTJ-IC-Arbiter.kicad_pcb]
2024-05-26 convert unused pin to gnd
    [XTJ-IC-Arbiter.kicad_pcb, XTJ-IC-Arbiter.kicad_sch]
2024-05-26 3.3v conn
    [XTJ-IC-Arbiter.kicad_pcb]
2024-05-26 safer 3.3v trace
    [XTJ-IC-Arbiter.kicad_pcb]
2024-05-26 drc fixes
    [XTJ-IC-Arbiter.kicad_pcb]
2024-05-26 fix orphaned c9
    [XTJ-IC-Arbiter.kicad_pcb, XTJ-IC-Arbiter.kicad_sch]
2024-05-26 fix unconnected pullup
    [XTJ-IC-Arbiter.kicad_pcb, XTJ-IC-Arbiter.kicad_sch]
2024-05-26 one more bypass
    [XTJ-IC-Arbiter.kicad_pcb, XTJ-IC-Arbiter.kicad_sch]
2024-05-26 Switch to single pole dip switches for CCD/CAN termination
    [XTJ-IC-Arbiter.kicad_pcb, XTJ-IC-Arbiter.kicad_sch]
2024-05-27 elminate some vias
    [XTJ-IC-Arbiter.kicad_pcb]
2024-05-27 current limiting on the ssd, tune can length
    [XTJ-IC-Arbiter.kicad_pcb, XTJ-IC-Arbiter.kicad_sch]
2024-05-27 Fix TVS diode for 12v to have reasonable working/breakdown ranges
    [XTJ-IC-Arbiter.kicad_pcb, XTJ-IC-Arbiter.kicad_sch]
2024-05-28 current limit the 12v measure prior to the ssd
    [XTJ-IC-Arbiter.csv, XTJ-IC-Arbiter.kicad_pcb, XTJ-IC-Arbiter.kicad_sch]
2024-05-28 cleanup schematic
    [XTJ-IC-Arbiter.kicad_sch]
2024-05-28 get input capacitor closer to power ic
    [XTJ-IC-Arbiter.kicad_pcb, XTJ-IC-Arbiter.kicad_sch]
2024-05-28 Tune CAN lengths
    [XTJ-IC-Arbiter.kicad_pcb]
2024-05-28 logo & copyright
    [XTJ-IC-Arbiter.kicad_pcb]
2024-05-28 bypass cap for tvs array
    [XTJ-IC-Arbiter.kicad_pcb, XTJ-IC-Arbiter.kicad_sch]
2024-05-29 tune ccd bus length
    [XTJ-IC-Arbiter.kicad_pcb]
2024-05-30 death to vias
    [XTJ-IC-Arbiter.kicad_pcb]
2024-06-01 Recalculate the 12v measure voltage dividers, and add a zener to limit to 3.3v
    [XTJ-IC-Arbiter.kicad_pcb, XTJ-IC-Arbiter.kicad_sch]
2024-06-01 ugly but functional
    [XTJ-IC-Arbiter.kicad_pcb, XTJ-IC-Arbiter.kicad_sch]
2024-06-01 less ugly
    [XTJ-IC-Arbiter.kicad_pcb, XTJ-IC-Arbiter.kicad_sch]
2024-06-01 polish, text
    [XTJ-IC-Arbiter.kicad_pcb, XTJ-IC-Arbiter.kicad_sch]
2024-06-01 oshpark colors
    [XTJ-IC-Arbiter.kicad_pcb]
2024-06-04 no battery relay
    [XTJ-IC-Arbiter.kicad_pcb, XTJ-IC-Arbiter.kicad_sch]
2024-06-06 bigger courtyard for the ccd module
    [G6L-1P DC5--3DModel-STEP-56544.STEP, G6L-1P_DC5.step, XTJ-IC-Arbiter.kicad_pcb, XTJ-IC-Arbiter.kicad_sch]
2025-08-30 Update to KiCad 9
    [XTJ-IC-Arbiter.kicad_pcb, XTJ-IC-Arbiter.kicad_sch]
2025-08-31 Fix labels
    [XTJ-IC-Arbiter.kicad_pcb]
2025-09-02 Working v3 layout
    [XTJ-IC-Arbiter.kicad_pcb, XTJ-IC-Arbiter.kicad_sch]
2025-09-02 Silkscreen cleanup
    [XTJ-IC-Arbiter.kicad_pcb]
2025-09-02 more updates
    [XTJ-IC-Arbiter.kicad_pcb, XTJ-IC-Arbiter.kicad_sch]
2025-09-02 differential skew tuning
    [XTJ-IC-Arbiter.kicad_pcb]
2025-09-04 drive towards 0 errors
    [XTJ-IC-Arbiter.kicad_pcb, XTJ-IC-Arbiter.kicad_sch]
2025-09-04 ignore KiCad locks
2025-09-04 Software pin updates, label test points on PCB
    [XTJ-IC-Arbiter.kicad_pcb, XTJ-IC-Arbiter.kicad_sch]
2025-09-04 Correct the power supply Cout specs
    [XTJ-IC-Arbiter.kicad_pcb, XTJ-IC-Arbiter.kicad_sch]
2025-09-06 Power 3.3v via a separate LDO rather than from the Teensy
    [XTJ-IC-Arbiter.kicad_pcb, XTJ-IC-Arbiter.kicad_sch]
2025-09-07 Add tons of detail and fixes to particular part numbers and footprints
    [FA24X7R1H105KRU06.stp, RLB0914-470KL.stp, SN74LV125AN.stp, XTJ-IC-Arbiter.kicad_pcb, XTJ-IC-Arbiter.kicad_sch]
2025-09-08 Swich to jumpers for bus termination
    [XTJ-IC-Arbiter.kicad_pcb, XTJ-IC-Arbiter.kicad_sch]
2025-09-08 Cleanup labels
    [XTJ-IC-Arbiter.kicad_pcb]
2025-09-08 Fix buffer footprint
    [XTJ-IC-Arbiter.kicad_pcb]
2025-09-08 Teensy 3D model
    [XTJ-IC-Arbiter.kicad_pcb]
2025-09-08 ERC fixes
    [XTJ-IC-Arbiter.kicad_pcb, XTJ-IC-Arbiter.kicad_sch]
2025-09-09 Ditch test points for vertical passives
    [XTJ-IC-Arbiter.kicad_pcb, XTJ-IC-Arbiter.kicad_sch]
2025-09-09 More layout tweaks, mostly around power
    [XTJ-IC-Arbiter.kicad_pcb, XTJ-IC-Arbiter.kicad_sch]
2025-09-10 Version using a TinyPICO ESP32 board
    [XTJ-IC-Arbiter.kicad_pcb, XTJ-IC-Arbiter.kicad_sch]
2025-09-10 fix CAN SPLIT termination
    [XTJ-IC-Arbiter.kicad_pcb, XTJ-IC-Arbiter.kicad_sch]
2025-09-12 Get BOM part #s correct
    [FA18X7R1H472KNU00.stp, XTJ-IC-Arbiter.csv, XTJ-IC-Arbiter.kicad_pcb, XTJ-IC-Arbiter.kicad_sch]
2025-09-12 further work on specifying components
    [XTJ-IC-Arbiter.kicad_pcb, XTJ-IC-Arbiter.kicad_sch]
2025-09-13 schematic cleanup
    [XTJ-IC-Arbiter.kicad_pcb, XTJ-IC-Arbiter.kicad_sch]
2025-09-13 Switch from label to proper power symbol for 3.3v
    [XTJ-IC-Arbiter.kicad_pcb, XTJ-IC-Arbiter.kicad_sch]
2025-09-15 Add a transistor to boost a weak speedo signal
    [XTJ-IC-Arbiter.kicad_pcb, XTJ-IC-Arbiter.kicad_sch]
2025-09-16 Add input cap for LDO
    [XTJ-IC-Arbiter.kicad_pcb, XTJ-IC-Arbiter.kicad_sch]
2025-09-17 update for parts I can actually purchase
    [XTJ-IC-Arbiter.kicad_pcb, XTJ-IC-Arbiter.kicad_sch]
2025-09-17 Avoid routing under the antenna
    [XTJ-IC-Arbiter.csv, XTJ-IC-Arbiter.kicad_pcb, XTJ-IC-Arbiter.kicad_sch]
2025-09-17 even more
    [XTJ-IC-Arbiter.kicad_pcb]
2025-09-17 remove probably bad idea diode
    [XTJ-IC-Arbiter.kicad_pcb, XTJ-IC-Arbiter.kicad_sch]
2025-09-18 Continued routing improvements
    [XTJ-IC-Arbiter.kicad_pcb, XTJ-IC-Arbiter.kicad_sch]
2025-09-20 Add the correct TE footprint including courtyard. Update antenna keep-out, more finesse
    [XTJ-IC-Arbiter.kicad_pcb, XTJ-IC-Arbiter.kicad_sch]
2025-09-20 Fix gnd plane
    [XTJ-IC-Arbiter.kicad_pcb]
2025-09-20 Fix last minute inconsistencies
    [XTJ-IC-Arbiter.kicad_pcb]
2025-09-20 among other things, creating more USB connector clearance
    [XTJ-IC-Arbiter.kicad_pcb, XTJ-IC-Arbiter.kicad_sch]
2025-09-20 length tune the extended I/Os, making it at least possible to use them for high speed signals
    [XTJ-IC-Arbiter.kicad_pcb, XTJ-IC-Arbiter.kicad_sch]
2025-09-20 Keep voltage test points at board edge to avoid shorts
    [XTJ-IC-Arbiter.kicad_pcb]
2025-09-20 fix DRC errors
    [XTJ-IC-Arbiter.kicad_pcb]
2025-09-20 silkscreen fixes
    [XTJ-IC-Arbiter.kicad_pcb]
2025-09-23 Re-layout power supply based on TI guidance and getting to know copper pours
    [XTJ-IC-Arbiter.kicad_pcb, XTJ-IC-Arbiter.kicad_sch]
2025-09-23 wip: moving the ESP32 antenna away from the power circuitry, in particular the inductor
    [XTJ-IC-Arbiter.kicad_pcb]
2025-09-23 tidy up schematic
    [XTJ-IC-Arbiter.kicad_pcb]
2025-09-23 add enclosure symbol/footprint
    [EEC-325X4A.step]
2025-09-23 still working to keep a clean ground plane
    [XTJ-IC-Arbiter.kicad_pcb, XTJ-IC-Arbiter.kicad_sch]
2025-09-24 try and fix the position of the enclosure keepout
    [XTJ-IC-Arbiter.csv, XTJ-IC-Arbiter.kicad_pcb, XTJ-IC-Arbiter.kicad_sch]
2025-09-24 Lock board, enclosure, edge cuts, and connector
    [XTJ-IC-Arbiter.kicad_pcb]
2025-09-24 F.Cu ground pour
    [XTJ-IC-Arbiter.kicad_pcb]
2025-09-26 Continued pour zone optimization
    [XTJ-IC-Arbiter.kicad_pcb]
2025-09-27 Keep power traces 0.05in from board edge, via rule
    [XTJ-IC-Arbiter.kicad_pcb]
2025-09-27 Via stitching
    [XTJ-IC-Arbiter.csv, XTJ-IC-Arbiter.kicad_pcb, XTJ-IC-Arbiter.kicad_sch]
2025-09-27 tie unused GPIOs to GND
    [XTJ-IC-Arbiter.kicad_pcb, XTJ-IC-Arbiter.kicad_sch]
2025-09-27 dont actually connect pins to ground, as that could result in a short if the pin is configured as output
    [XTJ-IC-Arbiter.kicad_pcb, XTJ-IC-Arbiter.kicad_sch]
2025-09-27 Get 12v measure closer to source
    [XTJ-IC-Arbiter.kicad_pcb, XTJ-IC-Arbiter.kicad_sch]
2025-09-29 uniform power net, shielding via stitching
    [XTJ-IC-Arbiter.kicad_pcb]
2025-09-29 ensure ext I/Os are length tuned
    [XTJ-IC-Arbiter.kicad_pcb]
2025-10-01 After the 4 layer adventure, cleanup
    [XTJ-IC-Arbiter.kicad_pcb]
2025-10-03 Hand tune the differential lengths (CAD/CCD)
    [XTJ-IC-Arbiter.kicad_pcb, XTJ-IC-Arbiter.kicad_sch]
2025-10-03 silkscreen work
    [XTJ-IC-Arbiter.kicad_pcb]
2025-10-04 re-route some traces to get contiguous front ground pours without vias
    [XTJ-IC-Arbiter.kicad_pcb]
2025-10-06 LDO caps were the wrong footprint
    [XTJ-IC-Arbiter.kicad_pcb, XTJ-IC-Arbiter.kicad_sch]
2025-10-07 Other footprint fixes
    [XTJ-IC-Arbiter.kicad_pcb, XTJ-IC-Arbiter.kicad_sch]
2025-10-07 colorize crucial nets
    [XTJ-IC-Arbiter.kicad_pcb]
2025-10-08 12v inrush limiting
    [XTJ-IC-Arbiter.kicad_pcb, XTJ-IC-Arbiter.kicad_sch]
2025-10-08 use a slow blow fuse to avoid a heat producing inrush resistor
    [XTJ-IC-Arbiter.kicad_pcb, XTJ-IC-Arbiter.kicad_sch]
2025-10-11 Add comparator
    [TLV3704IN.stp, XTJ-IC-Arbiter.kicad_pcb, XTJ-IC-Arbiter.kicad_sch]
2025-10-12 Layout tweaks
    [XTJ-IC-Arbiter.kicad_pcb, XTJ-IC-Arbiter.kicad_sch]
2025-10-12 resolve erc/drc errors
    [XTJ-IC-Arbiter.kicad_pcb, XTJ-IC-Arbiter.kicad_sch]
2025-10-12 net clarification
    [XTJ-IC-Arbiter.kicad_pcb, XTJ-IC-Arbiter.kicad_sch]
2025-10-15 Add an ambient thermometer, and use it to sleep the ESP32 if we get too hot. Presumably it'll be the MCU that gets us there
    [XTJ-IC-Arbiter.kicad_pcb, XTJ-IC-Arbiter.kicad_sch]
2025-10-15 move it to a cleaner spot
    [XTJ-IC-Arbiter.kicad_pcb, XTJ-IC-Arbiter.kicad_sch]
2025-10-17 relayout the board to get the antenna out to the edge with no copper beneath
    [XTJ-IC-Arbiter.kicad_pcb, XTJ-IC-Arbiter.kicad_sch]
2025-10-18 work on eliminating b.cu routes
    [XTJ-IC-Arbiter.kicad_pcb]
2025-10-18 Fix CDP clock signal
    [main.cpp]
2025-10-18 Lots of the signals coming out of the CDP are >0v at low, provide a ref volt for V- to the comparator for those
    [XTJ-IC-Arbiter.kicad_pcb, XTJ-IC-Arbiter.kicad_sch]
2025-10-18 respond to erc violations
    [XTJ-IC-Arbiter.kicad_pcb, XTJ-IC-Arbiter.kicad_sch]
2025-10-18 USB connector keepout
    [XTJ-IC-Arbiter.kicad_pcb]
2025-10-18 stiching vias
    [XTJ-IC-Arbiter.kicad_pcb]
2025-10-19 make the comparator's VREF configurable in the MCU
    [XTJ-IC-Arbiter.kicad_pcb, XTJ-IC-Arbiter.kicad_sch]
2025-10-19 Turns out the ESP32 DAC isn't very clean on analog, so use a voltage divider/RC for the comparator reference
    [XTJ-IC-Arbiter.kicad_pcb, XTJ-IC-Arbiter.kicad_sch]
2025-10-20 fix rule violations
    [XTJ-IC-Arbiter.kicad_pcb, XTJ-IC-Arbiter.kicad_sch]
2025-10-20 Double check and tune board edges
    [XTJ-IC-Arbiter.kicad_pcb, XTJ-IC-Arbiter.kicad_sch]
2025-10-22 Wrong TVS diode for 12v, need only be uni-dir
    [XTJ-IC-Arbiter.kicad_sch]
2025-10-23 reduce ground via tracks
    [XTJ-IC-Arbiter.kicad_pcb, XTJ-IC-Arbiter.kicad_sch]
2025-10-23 missed swapping the tvs diode bypass cap when rotating
    [XTJ-IC-Arbiter.kicad_pcb]
2025-10-28 Some more routing opt, fix up ref labels
    [XTJ-IC-Arbiter.kicad_pcb, XTJ-IC-Arbiter.kicad_sch]
2025-10-30 Wider base track widths, stitching vias
    [XTJ-IC-Arbiter.kicad_pcb]
2025-10-31 improve clearance
    [XTJ-IC-Arbiter.kicad_pcb, XTJ-IC-Arbiter.kicad_sch]
2025-10-31 eliminate f.cu pour
    [XTJ-IC-Arbiter.kicad_pcb]
2025-10-31 dont overthink tinypico thermals
    [XTJ-IC-Arbiter.kicad_pcb]
2025-10-31 via elimination
    [XTJ-IC-Arbiter.kicad_pcb, XTJ-IC-Arbiter.kicad_sch]
2025-10-31 re-tune CCD traces
    [XTJ-IC-Arbiter.kicad_pcb]
2025-11-01 more iteration
    [XTJ-IC-Arbiter.kicad_pcb]
2025-11-02 better isolation of power traces and power pins in the connector
    [XTJ-IC-Arbiter.kicad_pcb, XTJ-IC-Arbiter.kicad_sch]
2025-11-07 Switch to 1a fast blow fuses.
    [XTJ-IC-Arbiter.csv, XTJ-IC-Arbiter.kicad_pcb, XTJ-IC-Arbiter.kicad_sch]
2025-11-08 re-layout switcher for lower emi
    [XTJ-IC-Arbiter.kicad_pcb]
2025-11-08 Lots of fun cleanup made possible by the supply re-layout
    [XTJ-IC-Arbiter.kicad_pcb, XTJ-IC-Arbiter.kicad_sch]
2025-11-10 battery wip
    [XTJ-IC-Arbiter.kicad_pcb, XTJ-IC-Arbiter.kicad_sch]
2025-11-10 change bat vdiv values
    [XTJ-IC-Arbiter.kicad_pcb, XTJ-IC-Arbiter.kicad_sch]
2025-11-12 Add an input side diode to the regulator circuit to prevent reverse voltage when USB is connected but 12v is not
    [XTJ-IC-Arbiter.kicad_pcb, XTJ-IC-Arbiter.kicad_sch]
2025-11-12 schottky on output too
    [XTJ-IC-Arbiter.kicad_pcb, XTJ-IC-Arbiter.kicad_sch]
2025-11-15 teardrop power nets
    [XTJ-IC-Arbiter.kicad_pcb, XTJ-IC-Arbiter.kicad_sch]
2025-11-15 fix comparator unused input
    [XTJ-IC-Arbiter.kicad_pcb, XTJ-IC-Arbiter.kicad_sch]
2025-11-15 unify the 4.7nF caps
    [XTJ-IC-Arbiter.kicad_pcb, XTJ-IC-Arbiter.kicad_sch]
2025-11-15 Global to local labels
    [XTJ-IC-Arbiter.kicad_pcb, XTJ-IC-Arbiter.kicad_sch]
2025-11-15 schematic tidying
    [XTJ-IC-Arbiter.kicad_pcb, XTJ-IC-Arbiter.kicad_sch]
2025-11-16 attempt to keep traces clear of pads, remove unnecessary opts
    [XTJ-IC-Arbiter.kicad_pcb, XTJ-IC-Arbiter.kicad_sch]
2025-11-16 unsaved changes
    [XTJ-IC-Arbiter.kicad_pcb]
2025-11-16 thermo code
    [XTJ-IC-Arbiter.kicad_pcb, XTJ-IC-Arbiter.kicad_sch]
2025-11-17 Flip CAN chip to get more clearance for the USB connector
    [XTJ-IC-Arbiter.kicad_pcb, XTJ-IC-Arbiter.kicad_sch]
2025-11-18 Finished CAN validation
    [XTJ-IC-Arbiter.kicad_pcb, XTJ-IC-Arbiter.kicad_sch]
2025-11-18 Switch to resettable fuses and delete the 5v out diode (too much forward voltage drop)
    [RXEF050S.stp, XTJ-IC-Arbiter.kicad_pcb, XTJ-IC-Arbiter.kicad_sch]
2025-11-19 Switch to SMT resettable fuses
    [MF-MSMF050.step, XTJ-IC-Arbiter.kicad_pcb, XTJ-IC-Arbiter.kicad_sch]
2025-11-19 power notes
2025-11-19 route speed/idle through via to avoid sig over gap
    [XTJ-IC-Arbiter.kicad_pcb]
2025-11-19 one more tweak
    [XTJ-IC-Arbiter.kicad_pcb]
2025-11-19 last minute change
    [XTJ-IC-Arbiter.kicad_pcb]
2025-12-17 Starting v3.1: USB cable is too tight a fit on v3.0, make more room even for a right angle connector
    [XTJ-IC-Arbiter.kicad_pcb, XTJ-IC-Arbiter.kicad_sch]
2025-12-17 use some signal vias to simplify power distribution
    [XTJ-IC-Arbiter.kicad_pcb, XTJ-IC-Arbiter.kicad_sch]
2025-12-18 cleanup 90s
    [XTJ-IC-Arbiter.kicad_pcb, XTJ-IC-Arbiter.kicad_sch]
2025-12-27 fix some erc probs
    [XTJ-IC-Arbiter.kicad_pcb, XTJ-IC-Arbiter.kicad_sch]
2026-05-04 dont fear the via
    [XTJ-IC-Arbiter.kicad_pcb]
2026-05-05 larger power traces
    [XTJ-IC-Arbiter.kicad_pcb]
2026-05-17 try to simplify the 3v3 net
    [XTJ-IC-Arbiter.kicad_pcb]
2026-07-14 more antenna copper keepout
    [XTJ-IC-Arbiter.kicad_pcb, XTJ-IC-Arbiter.kicad_sch]
2026-08-02 power tweaks, dont fear layer 2
    [XTJ-IC-Arbiter.kicad_pcb, XTJ-IC-Arbiter.kicad_sch]
2026-08-02 reverse polarity protection on 5v out
    [XTJ-IC-Arbiter.kicad_pcb, XTJ-IC-Arbiter.kicad_sch]
2026-08-02 more use of bcu
    [XTJ-IC-Arbiter.kicad_pcb, XTJ-IC-Arbiter.kicad_sch]
2026-08-02 still tweaking
    [XTJ-IC-Arbiter.kicad_pcb]
2026-08-04 freakout relayout of power supply based on new info
    [XTJ-IC-Arbiter.kicad_pcb]
2026-08-16 relayout the power supply yet again
    [XTJ-IC-Arbiter.kicad_pcb]
2026-08-17 Remove solder jumpers. People can simply populate/not populate the CCD/CAN termination
    [XTJ-IC-Arbiter.kicad_pcb, XTJ-IC-Arbiter.kicad_sch]
