sgmiller/tj-cluster/(notices)

Notices in the files:
pcb/parts/Jumpers/TSW-101-07-T-D.stp:
FILE_NAME( 'e:/temp/worker_630/temp/exporttempdir_3324_158_Dk3SU/format_0/TSW-101-07-T-D.stp', '2022-05-31T11:16:49', ( 'License CC BY-ND 4.0' ), ( 'CADENAS' ), ' ', 'PARTsolutions', ' ' );
